junggeehoon/Furuta-Pendulum/assets/16a5a4c0-48b7-421a-93c6-b03f491bbfe6.png

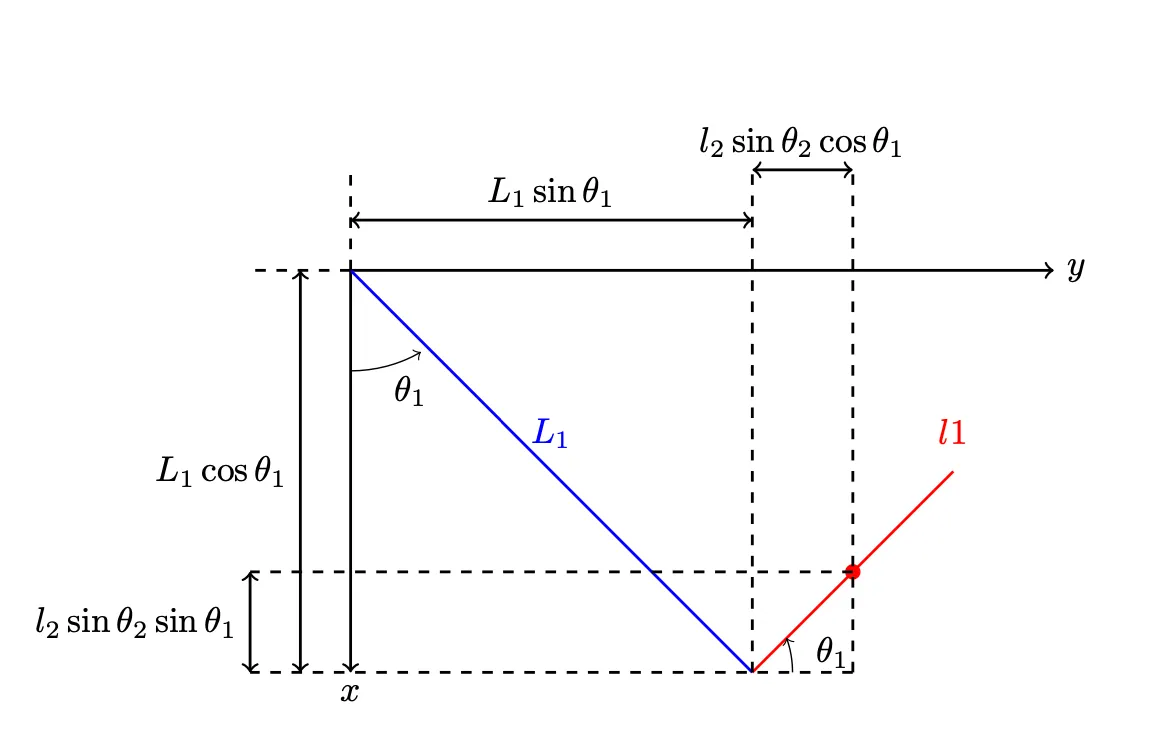
assets/16a5a4c0-48b7-421a-93c6-b03f491bbfe6.png
