junggeehoon/Furuta-Pendulum/assets/80eb68e7-3692-4634-a45e-2ed3875efcf0.png

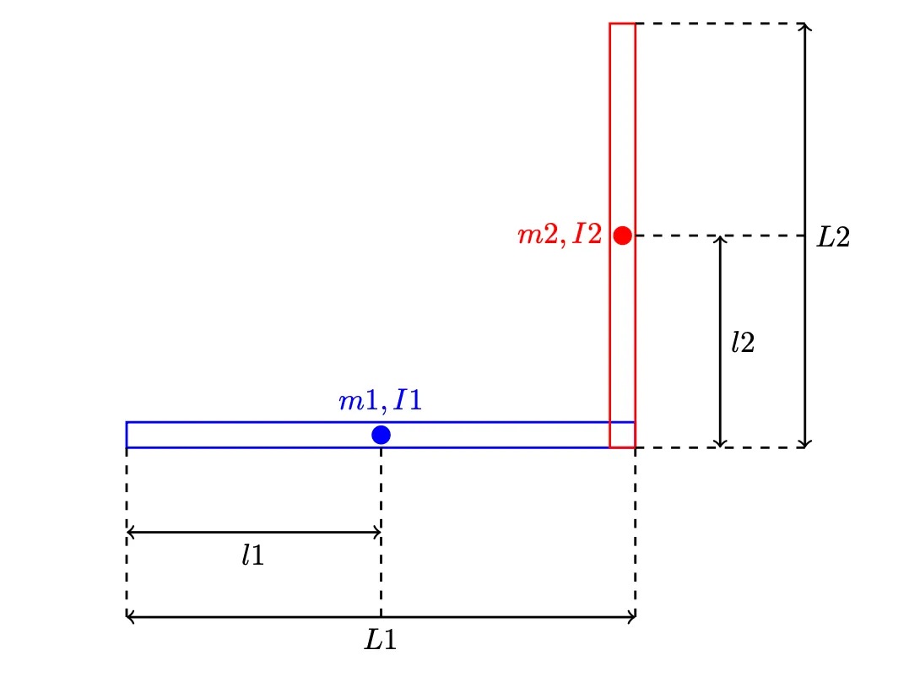
assets/80eb68e7-3692-4634-a45e-2ed3875efcf0.png
