junggeehoon/Furuta-Pendulum/assets/373b8be1-dd87-4a1c-aecf-741776162d71.png

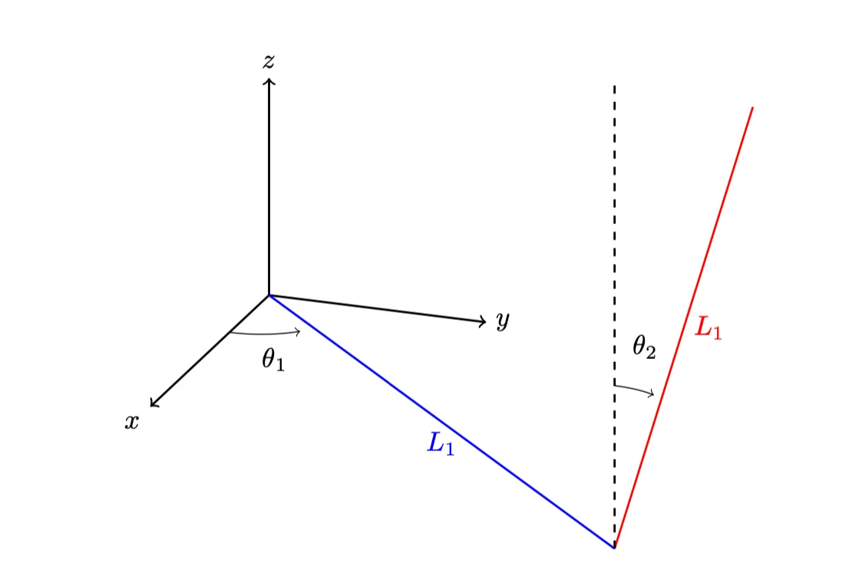
assets/373b8be1-dd87-4a1c-aecf-741776162d71.png
