junggeehoon/Furuta-Pendulum/assets/IMG_5578.jpg

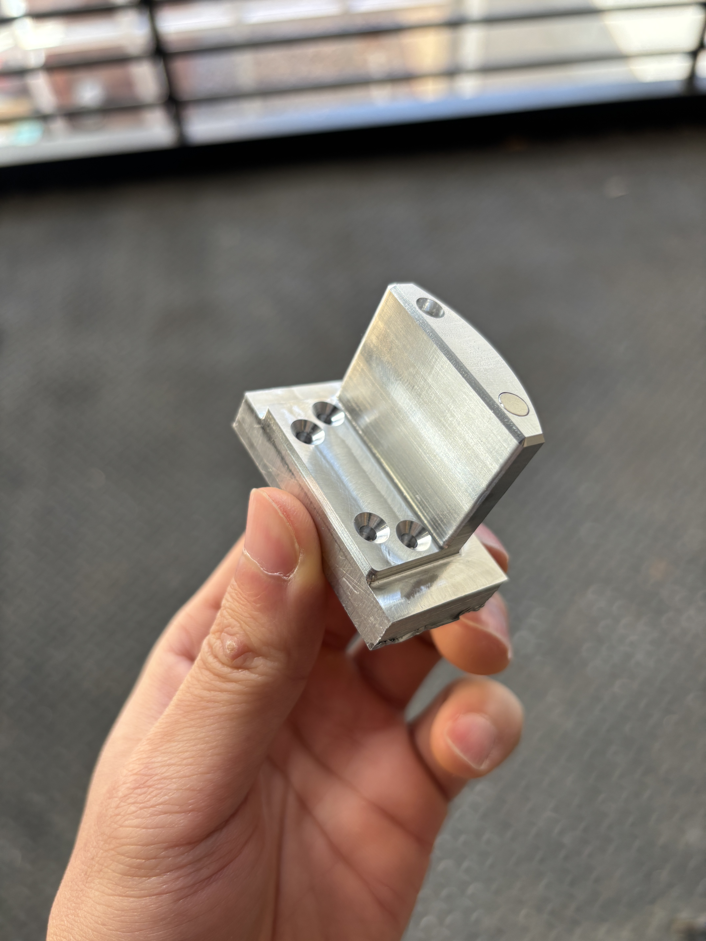
[picture p10: assets/IMG_5578.jpg]
assets/IMG_5578.jpg
