junggeehoon/Furuta-Pendulum/assets/IMG_5644.jpg

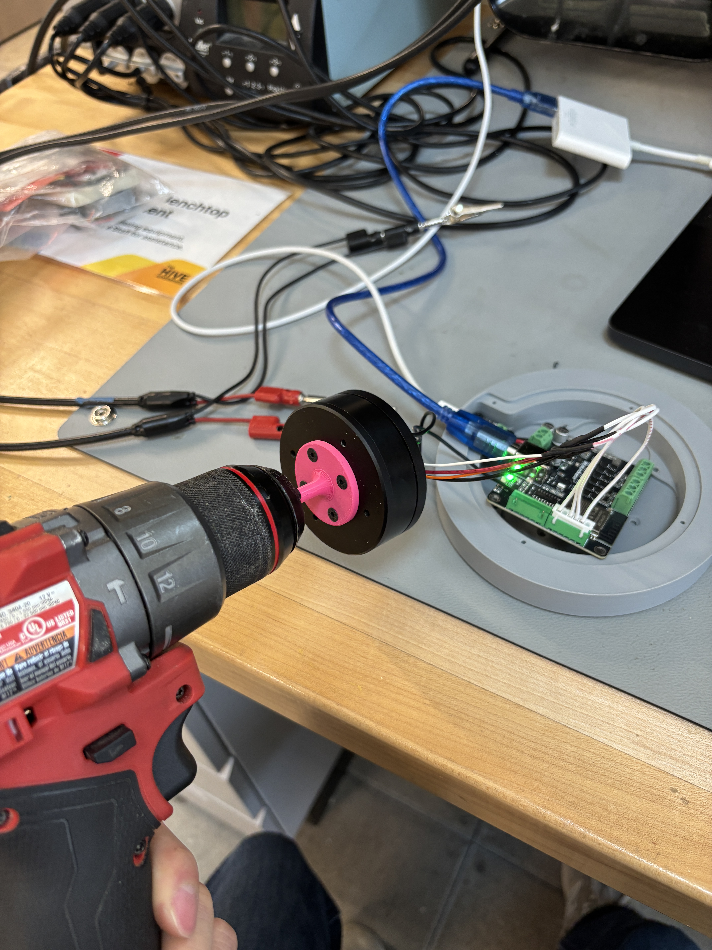
[picture p15: assets/IMG_5644.jpg]
assets/IMG_5644.jpg
