junggeehoon/Furuta-Pendulum/assets/IMG_5646.jpg

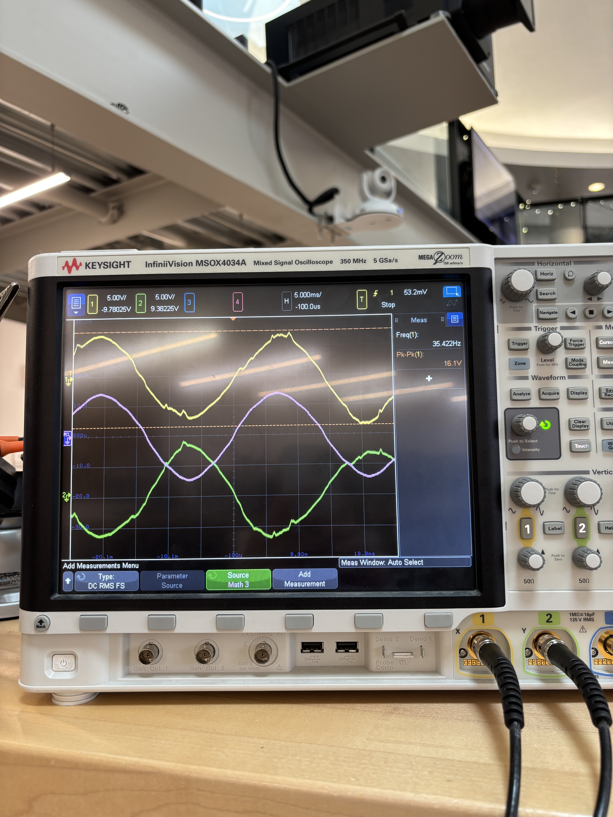
[picture p16: assets/IMG_5646.jpg]
assets/IMG_5646.jpg
